uendercarlos/spectral-iot-grain-analysis/diagrama.png

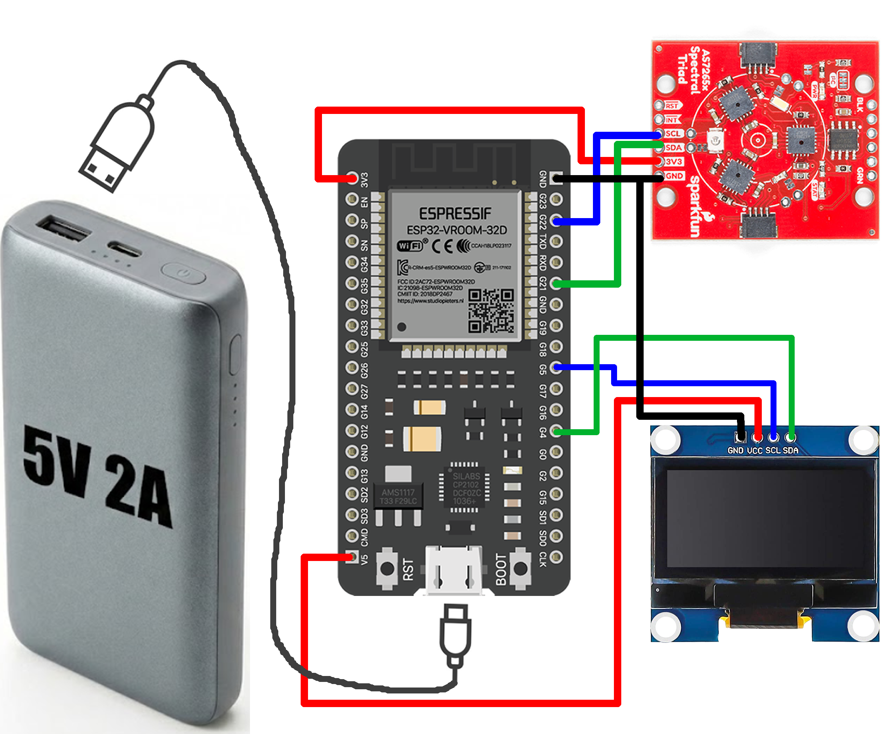
diagrama.png
